SeanWHughes/Pull-Up-Detection-Reward/README.md

# Pull-Up-Detection-Reward
A fun Arduino device for students in quarantine wanting to stay fit; it detects proper pull-up form and rewards the user with candy or healthy snacks upon reaching a user-defined level of difficulty for the workout. My final project for MAE 3780: Mechatronics

# Instructions
To read the final report, go to Pull-Up Detection Reward Device (Paper).pdf in the repository

To see my Arduino code, go to Pull-Up Detection Reward Device.ino
